AlexGyver/ColorMusic/schemes/divide.jpg

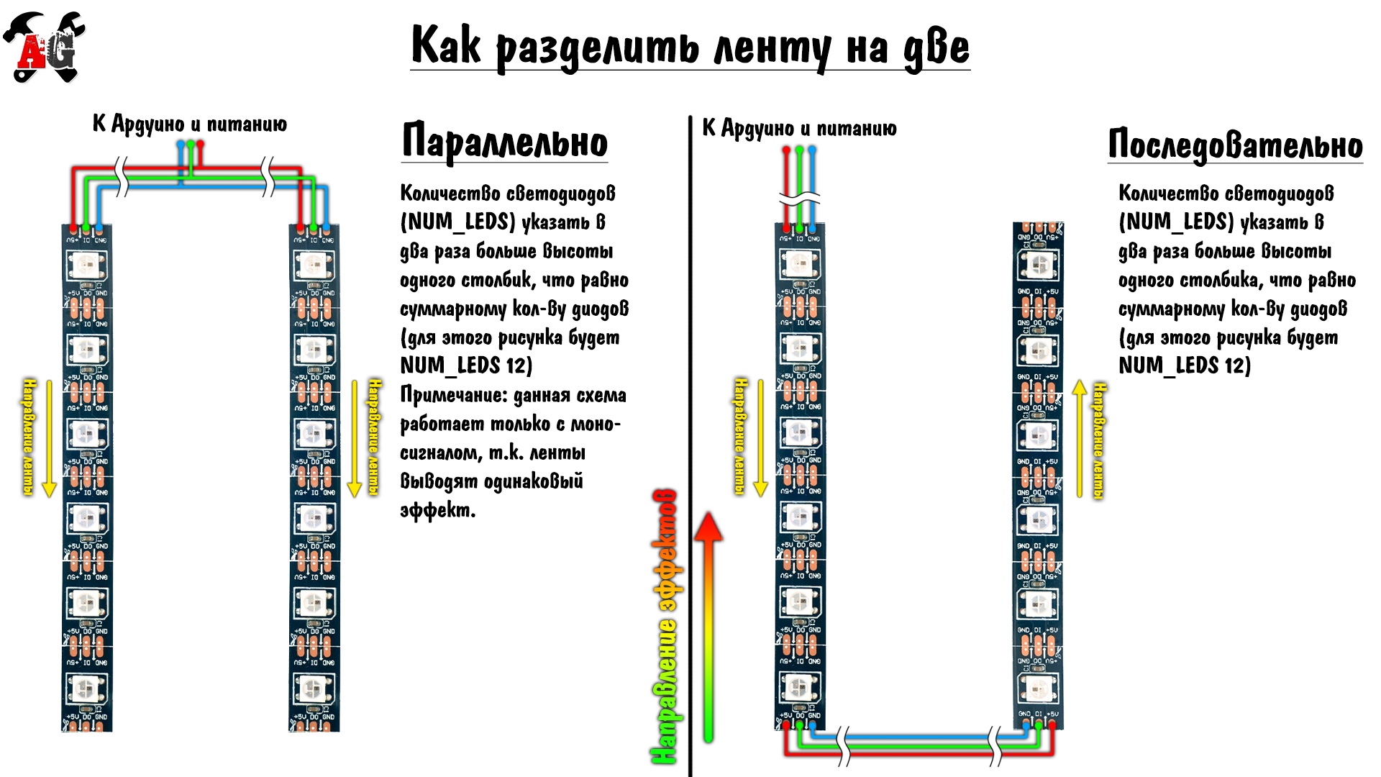
schemes/divide.jpg
