AlexGyver/ColorMusic/schemes/scheme5.jpg

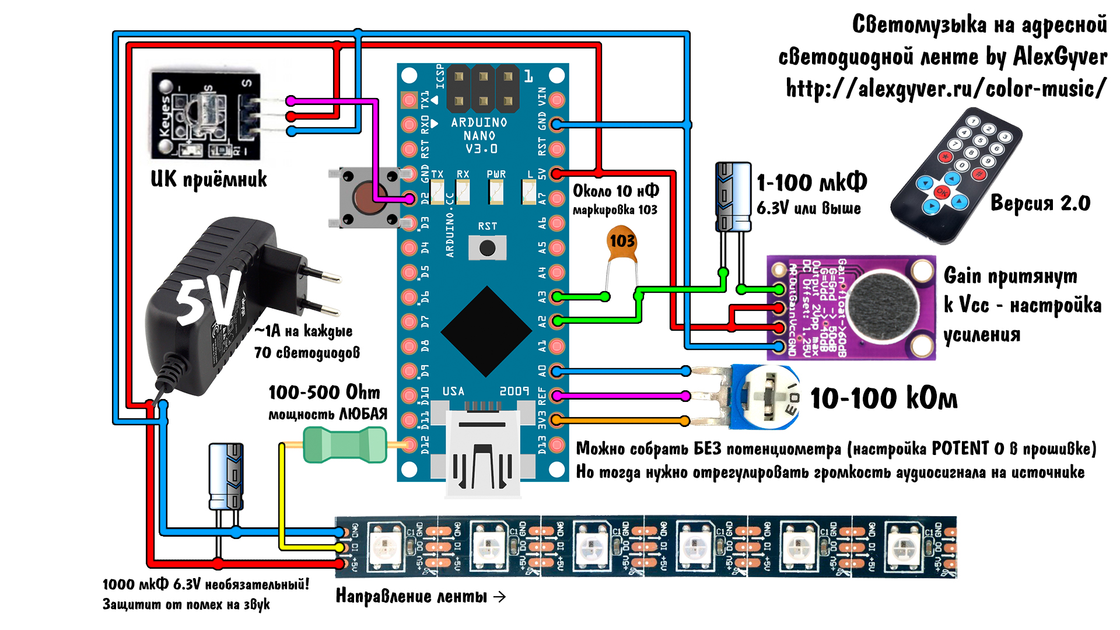
schemes/scheme5.jpg
