AlexGyver/ColorMusic/schemes/scheme6.jpg

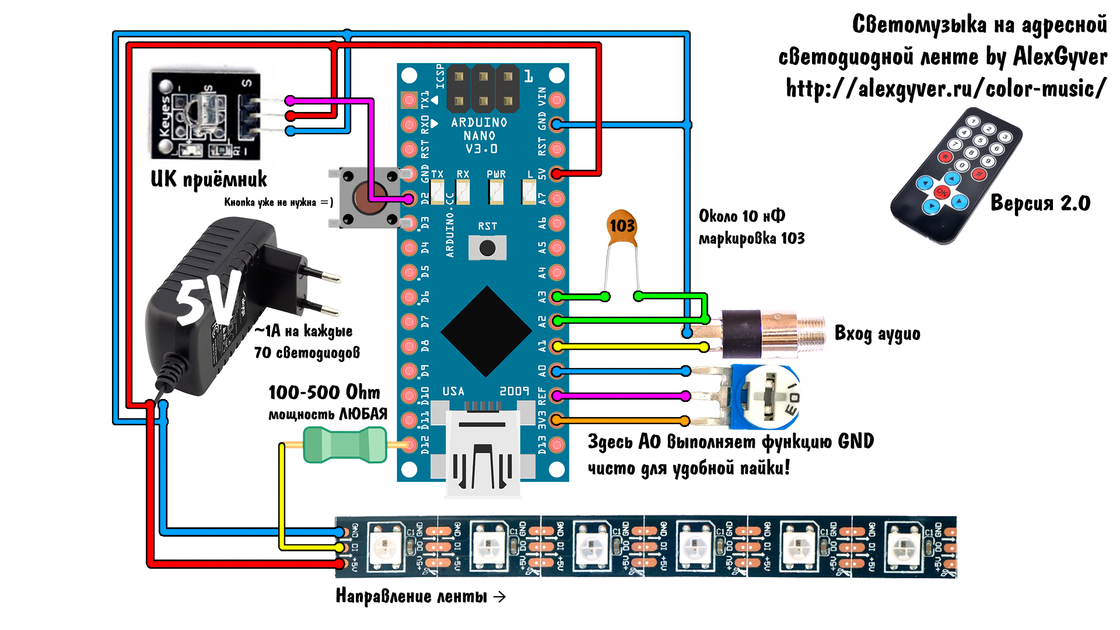
schemes/scheme6.jpg
