AlexGyver/ColorMusic/(threads)

Thread 1 (2018-05-22):

Проблема со схемой с микрофоном.

rfdrew, 2018-05-22:
Может быть я такой везучий, но при работе схемы с микрофоном нашел баг. При первом режиме работы, загорается и горит пол ленты. Когда крутишь резистор добавляешь или уменьшаешь количество светодиодов которые горят. Потом постепенно количество светящихся светодиодов приходит в норму. Калибровка шума не помогает. Лечится добавлением резистора, я ставил 10-30 кОм(Больше не было) все приходит в норму. Немного страдает чувствительность, но на 30 КОм она уже не значительная.
Проверьте и добавьте себе в проект это изменение. Если нужно могу видео предоставить с объяснениями.
PS: Используется Arduino UNO, все остальное как в проекте.

CharlzVard, 2018-05-30:
Решается заменой типа byte на int в строках 116 и 236.

AlexGyver, 2018-06-14:
В версии 2.6.1 это исправлено

kurtveliev, 2020-01-27:
> Может быть я такой везучий, но при работе схемы с микрофоном нашел баг. При первом режиме работы, загорается и горит пол ленты. Когда крутишь резистор добавляешь или уменьшаешь количество светодиодов которые горят. Потом постепенно количество светящихся светодиодов приходит в норму. Калибровка шума не помогает. Лечится добавлением резистора, я ставил 10-30 кОм(Больше не было) все приходит в норму. Немного страдает чувствительность, но на 30 КОм она уже не значительная.
> Проверьте и добавьте себе в проект это изменение. Если нужно могу видео предоставить с объяснениями.
> PS: Используется Arduino UNO, все остальное как в проекте.

**Добрый** день! У меня такая же проблема на новой прошивке 2.10. Схема с микрофоном, не работают первые 2 режима. Пожалуйста подскажите какие именно строки нужно поменять?**

kurtveliev, 2020-01-27:
> Решается заменой типа byte на int в строках 116 и 236. (версия 2.6, по крайней мере)

Какие именно строки? в прошивке 2.10 я так понимаю этой проблемы быть не должно, но у меня все же первые два режима не работают должным образом

CharlzVard, 2020-01-27:
> Какие именно строки? в прошивке 2.10 я так понимаю этой проблемы быть не должно, но у меня все же первые два режима не работают должным образом

А открыть  версию 2.6 и посмотреть?

116: uint16_t LOW_PASS = 100;
236: byte low_pass;

kurtveliev, 2020-01-27:
Cпасибо, но не помогло(

CharlzVard, 2020-01-27:
Калибровку делали?

kurtveliev, 2020-01-27:
да, что только не делал. И на другие аналоговые пины перекидывал, и потенциометром пробовал, и вручную в прошивке пробовал подобрать. И конденсатор менял. Единственное не пробовал другой резистор на LED. Но дело в том что с третего режима все прекрасно работает, а первые два просто плавно горит часть диодов и никакого движения

DaniilGlubochenko, 2020-02-02:
Друзья, тоже столкнулся с это проблемой. Смена типа в 116 и 236 строках не помогла. Также работают все режимы, кроме 1-го и 2-го. Пробовал и на прошивке 2.10 и на 2.6.

Подскажите, пожалуйса, как можно решить?

pitybull, 2020-02-12:
и у меня тоже эта проблема . Первые два режима не работают . Собрал Схему с микрофонам  Версия 2.10
что делать?
@AlexGyver  помоги пожалуйста

DaniilGlubochenko, 2020-02-12:
> и у меня тоже эта проблема . Первые два режима не работают . Собрал Схему с микрофонам Версия 2.10
> что делать?
> @AlexGyver помоги пожалуйста

Привет!

Добрался я до вот этого обсуждения.
https://community.alexgyver.ru/threads/cvetomuzyka-na-arduino-obsuzhdenie-proekta.126/

Там в постах есть несколько решений этой проблемы. Полистай, не помню на какой именно страничке. Я пока что еще ничего не пробовал.

Отпишись плиз о результатах потом.

pitybull, 2020-02-17:
Я решил проблемы с первым и вторим режимом.
Прочитал все 47 страниц.
https://community.alexgyver.ru/threads/cvetomuzyka-na-arduino-obsuzhdenie-proekta.126/
avalonix на 25 странице и viktor001 пару раз писали что делать.
avalonix впаял 45k Резистор viktor001 10к Резистор

viktor001 объяснил это так
https://community.alexgyver.ru/threads/cvetomuzyka-na-arduino-obsuzhdenie-proekta.126/page-44#post-21834

> Если у вас помимо синего фона, без сигнала на входе, светятся какое то количество пикселей, то это говорит о наличие потенциала на этом самом входе. Грубо говоря напряжение, которого не должно быть. Для этого в схему внесён дополнительный резистор между А2 и минусом.

Я впаял Резистор 10к между А2 и GND на arduino, откалибровал звук и всё заработало.

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

kurtveliev, 2020-02-17:
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

Спасибо большое, на досуге буду пробовать. Я насчет резистора смекнул, но впаял его последовательно перед кондером и ничего не помогло ( делетант в этом деле)

kurtveliev, 2020-02-17:
впаял на 20ком по совету выше и все заработало! Спасибо!

DaniilGlubochenko, 2020-02-18:
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

Гран мерси за инфу! На выходных доберусь до радиорынка и тоже буду пробовать.

Thread 2 (2018-07-04):

Не работает анализатор спектра на ленте короче 40 светодиодов

CharlzVard, 2018-07-04:

SAn4Es-TV, 2020-05-09:
Вы решили проблему?
У меня на последнем режиме все светодиоды горят одновременно.

Butylkus, 2020-05-16:
Скорее всего не проблема, а логика - последний режим имеет очень много полос и ему тупо не хватает диодов. Причём полосы, как я понимаю, захватывают не менее 3 диодов. Таким образом, нужно как минимум по 6 на каждую (симметрично влево и вправо по 3). Даже для 5 полос это уже 30, а там этих полос штук 15.

SAn4Es-TV, 2020-05-16:
А почему тогда цвет на каждый диод?

Thread 3 (2018-09-20):

Плата:"Arduino/Genuino Mega or Mega 2560, ATmega2560 (Mega 2560)"

Evg33, 2018-09-20:
Arduino: 1.8.6 (Windows 8.1), Плата:"Arduino/Genuino Mega or Mega 2560, ATmega2560 (Mega 2560)"

exit status 1
'INTERNAL' was not declared in this scope

Closed 2018-09-28.

Thread 5 (2018-09-20):

Предупреждение про  if ((long)millis() - strobe_timer > STROBE_PERIOD)  при компиляции

Evg33, 2018-09-20:
\colorMusic_v2.6.2_WAVGAT\colorMusic_v2.6.2_WAVGAT.ino: In function 'void mainLoop()':

\colorMusic_v2.6.2_WAVGAT\colorMusic_v2.6.2_WAVGAT.ino:426:43: warning: comparison between signed and unsigned integer expressions [-Wsign-compare]

         if ((long)millis() - strobe_timer > STROBE_PERIOD) {

                                           ^

Evg33, 2018-09-20:
#6

Closed 2018-09-28.

Thread 7 (2018-09-20):

Несколько пультов в одном коде.

Evg33, 2018-09-20:
Не удобнее будет, если все пульты будут находиться в одном коде ?
С помощью директив препроцессора переключать нужный код при компиляции.
Т.е. в бинарнике будет только нужный пульт.

Closed 2018-09-28.

Thread 9 (2018-09-20):

Arduino Pro Micro

Evg33, 2018-09-20:
Думаю стоит включить поддержку Arduino Pro Micro

У промикры есть 2 недостатка:
1. Она дороже рублей на 50 (0.7$).
2. У неё не выведен на ноги платы AREF, потому потенциометр можно подключить только подпаиваясь под линзой к плате на 42й вывод МК или проще на С1 (на он плате между GND и RESET http://i.imgur.com/ufiWvdz.jpg ). Но с MAX9814 мне AREF и не потребовался.

Но зато есть и достоинства:
1. Меньше размером.
2. Больше оперативки, т.е. на 180 светодиодов больше держать может.
3. Есть 2 варианта. С MicroUSB и с MiniUSB (на фотке с MicroUSB (чип без поворота), на схеме ниже MiniUSB (чип под углом 45 к кромке платы)).
Оба варианта посмотреть можно тут: https://ru.aliexpress.com/item/1-TENSTAR-Pro-Micro-AT..

Компиляция colorMusic_v2.6.2_WAVGAT позволяет:
Nano: max 388 светодиодов;
ProMicro: max 569 светодиодов.

Компиляция colorMusic_v1.1.ino:
Nano: max 439 светодиодов;
Pro Micro: max 622 светодиодов.

Closed 2018-09-28.

Thread 11 (2018-10-25):

Как изменить точку начала?

MidzakiKayo, 2018-10-25:
На видео видно что лента зажигается с середины. Но как изменить это место? Хочу сделать квадрат и п-образное ответвление. И несколько точек зажигания. Две на квадрате и две на п-образном ответвление.Его планирую подключить через развитвитель. Кто может помочь советом?

Thread 14 (2019-03-09):

Снять сигнал с выхода усилителя - рекомендуемая схема делителя выходного напряжения

dimzon, 2019-03-09:
Привет. На стенке сверху заброшены 2 колонки от музыкального центра и bluetooth услилитель класса d. Питалние 12 вольт от компьютерного старого БП (заодно есть запас по мощности огромный например для светомузыки)
Соответственно линейного входа нету, можно брать с выхода усилителя через делитель на резисторах. Если максимальное напряжение на выходе = напряжение питания = 12 вольт какие параметры резисторов посоветуешь?

dimzon, 2019-03-09:
Нашел на сайте только там почему-то моно. Пофиксим ;)

ArthurAzatian, 2019-11-19:
Напиши плиз что в итоге получилось

Thread 15 (2019-04-08):

Неправильные цвета? Есть решение

Butylkus, 2019-04-08:
Столкнулся с проблемой "из коробки".
Моя лента использует порядок РГБ, то есть стандартные для цветного мира наборы байт.
Настраиваю под себя, прописываю высокие на фиолетовый цвет, средние на лимонный, а басы на бордовый. Проверяю - циановый, сопливо-зелёный и зелёный 0_о
СРазу понимаю, что порядок явно не тот.
Рою код и нахожу:
`void setup() {
  Serial.begin(9600);
  FastLED.addLeds<WS2811, LED_PIN, GRB>(leds, NUM_LEDS).setCorrection( TypicalLEDStrip );
  if (CURRENT_LIMIT > 0) FastLED.setMaxPowerInVoltsAndMilliamps(5, CURRENT_LIMIT);
  FastLED.setBrightness(BRIGHTNESS);`

Само собой, решение очевидно, надо передавать либе правильный порядок.
Алекс, занеси это в настройки (строка с порядком как константа под дефайном).
Надеюсь, многих выручил.

Хорошая фигня, будет время - займусь перепилю на питоне для малины =)

Thread 16 (2019-04-20):

30 дизайнов цветомузыки и более 90 обычных эффектов на esp8266 и mqtt

anrada73, 2019-04-20:
https://www.youtube.com/watch?v=IG_WMCPlVx4

denis86111, 2020-04-06:
классная штука, только где скачать прошивку pro?

anrada73, 2020-04-06:
https://www.youtube.com/watch?v=DUdIw5CBIhU&t   в описании есть демо версия и как со мной связаться

Closed 2019-10-25.

Thread 17 (2019-11-19):

Добавление цветов

ArthurAzatian, 2019-11-19:
Здравствуйте, подскажите пожалуйста как добавить в проект цветов?
/*
  Цвета для HSV
  HUE_RED
  HUE_ORANGE
  HUE_YELLOW
  HUE_GREEN
  HUE_AQUA
  HUE_BLUE
  HUE_PURPLE
  HUE_PINK
*/
Это весь список доступный в проекте

Thread 18 (2019-12-25):

Переключение режима на ходу

vesh95, 2019-12-25:
#13
Почему бы не сделать фичу для переключения режима управления на ходу?
Не думаю, что хардкодить в прошивке - это удобно.

Как там дела с памятью устройства?

Thread 24 (2023-04-17):

не работает библиотека FHT что делать помогите

ArtemFBR12, 2023-04-17:
при попитке компилировать скетч новий иде не видит библиотеку.
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

Flarion-ion, 2023-10-06:
Она у тебя не установлена просто, скопирую папку FHT (https://github.com/AlexGyver/ColorMusic/tree/master/libraries) в папку с библиотеками Arduino, ну в крайнем случае в папку с проетом и измени <FHT.h> на "FHT/FHT.h"
