AlexGyver/ColorMusic/(commit log)

2018-09-20 Поддержка Arduino/Genuino Mega or Mega 2560 [issue #3]
    [colorMusic_v2.6.2_KEYES.ino, colorMusic_v2.6.2_WAVGAT.ino]
2018-09-20 Поддержка нескольких пультов в одном коде [issue #7]
    [colorMusic_v2.6.2_WAVGAT.ino]
2018-09-20 Поддержка Arduino Pro Micro [issue #9]
    [colorMusic_v2.6.2_WAVGAT.ino]
